pctong/Arduino-clock-with-BigBenChime/clock.png

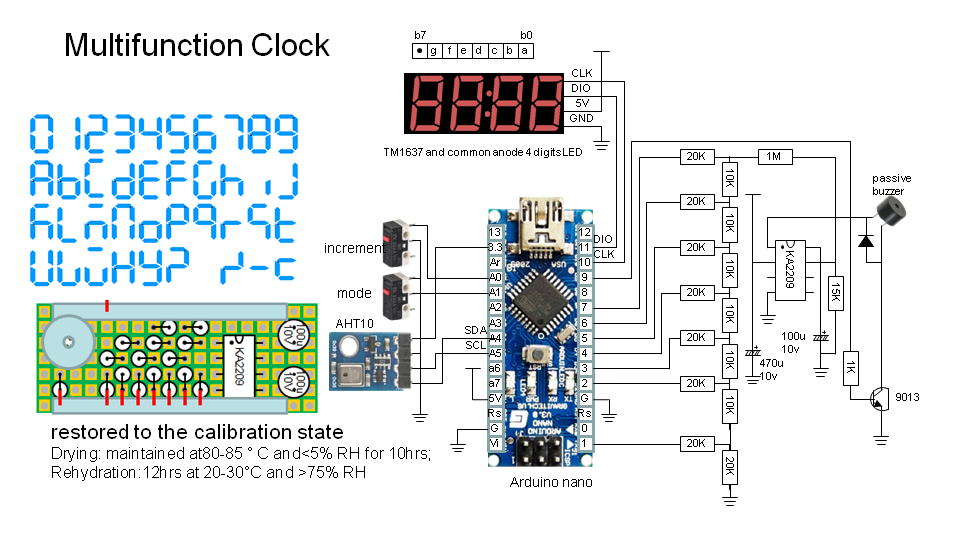
clock.png
